VIP-LES/flight-computer-pcb/LEOS-flight-computer.csv

Reference | Qty | Value | Manufacturer | MPN | Digikey | LCSC | Description
BT1 | 1 | GPS Battery Backup | Memory Protection Devices | BU2032SM-JJ-GTR | BU2032SM-JJ-GCT-ND |  | CR2032 Backup Battery Holder
C1,C2 | 2 | 10p | Samsung Electro-Mechanics | CL10C100JB8NNNC | 1276-1027-1-ND | C1634 | 10P 50V C0G 0603
C3,C5,C7,C12 | 4 | 0.1u | Samsung Electro-Mechanics | CL10B104KB8NNNL | 1276-CL10B104KB8NNNLCT-ND | C913912 | 0.1U 50V X7R 0603
C4,C6 | 2 | 1u | Samsung Electro-Mechanics | CL10B105KA8NNNC | 1276-1184-1-ND | C29936 | 1U 25V X7R 0603
C8,C9 | 2 | 22u | Samsung Electro-Mechanics | CL21A226MAYNNNE | 1276-CL21A226MAYNNNECT-ND | C29936 | 22U 25V X5R 0805
D1 | 1 | Red LED | Lite-On Inc. | LTST-C150KRKT | 160-1405-1-ND |  | Red 631nm LED Indication - Discrete 2V 1206
D2 | 1 | Yellow LED | Lite-On Inc. | LTST-C150KSKT | 160-1406-1-ND |  | Yellow 591nm LED Indication - Discrete 2.1V 1206
D3 | 1 | Green LED | Lite-On Inc. | LTST-C230KGKT | 160-1456-1-ND |  | Green 571nm LED Indication - Discrete 2V 1206
J1,J2 | 2 | MicroFit_1x4 | Molex | 0436500409 | WM1882CT-ND | C563846 | Molex MicroFit3.0 1x4 Bus Connector
J4 | 1 | JST XH | JST | S4B-XH-A | 455-2243-ND |  | JST XH
J5 | 1 | JST XH | JST | S6B-XH-A | 455-S6B-XH-A-ND |  | JST XH
R1 | 1 | 120 | Stackpole Electronics Inc | CF14JT120R | CF14JT120RCT-ND |  | Resistor
R2,R3 | 2 | 4.7k | Vishay Dale | CRCW08054K70FKEA | 541-4.70KCCT-ND |  | 4.7 kOhms ±1% 0.25W, 1/4W Chip Resistor 0805
R4,R5,R6 | 3 | 130 | Vishay Dale | CRCW0805130RFKEA | 541-130CCT-ND |  | 130 Ohms ±1% 0.25W, 1/4W Chip Resistor 0805
SW1 | 1 | User Button | C&K | PTS645SK50-2 LFS | CKN9082-ND |  | Red Tactile Switch SPST-NO Top Actuated Through Hole
TP1 | 1 | CAN-H Test Point | Keystone Electronics | 5004 | 36-5004-ND |  | test point
TP2 | 1 | CAN-L Test Point | Keystone Electronics | 5116 | 36-5116-ND |  | test point
TP3 | 1 | 5V Test Point | Keystone Electronics | 5000 | 36-5000-ND |  | test point
TP4 | 1 | GND Test Point | Keystone Electronics | 5001 | 36-5001-ND |  | test point
U1 | 1 | MCP2562FD | Microchip Technology | MCP2562FDT-E/SN | MCP2562FDT-E/SNCT-ND | C511335 | High-Speed CAN Flexible Data Rate Transceiver
U2 | 1 | MCP2518FD | Microchip Technology | MCP2518FDT-E/SL | MCP2518FDT-E/SLCT-ND | C626758 | External CAN FD Controller with SPI Interface
U3 | 1 | SAM-M8Q | u-blox | SAM-M8Q-0 | 672-1054-1-ND |  | GPS ublox M8 variant
Y1 | 1 | 40 MHz | ECS Inc | ECS-400-10-37B2-CKY-TR | 50-ECS-400-10-37B2-CKY-TRCT-ND | C5357833 | 40 MHz ±10ppm Crystal 10pF 40 Ohms
