VIP-LES/flight-computer-pcb/LEOS-flight-computer.kicad_pcb

## KiCad design LEOS-flight-computer.kicad_pcb (2026-10-07)

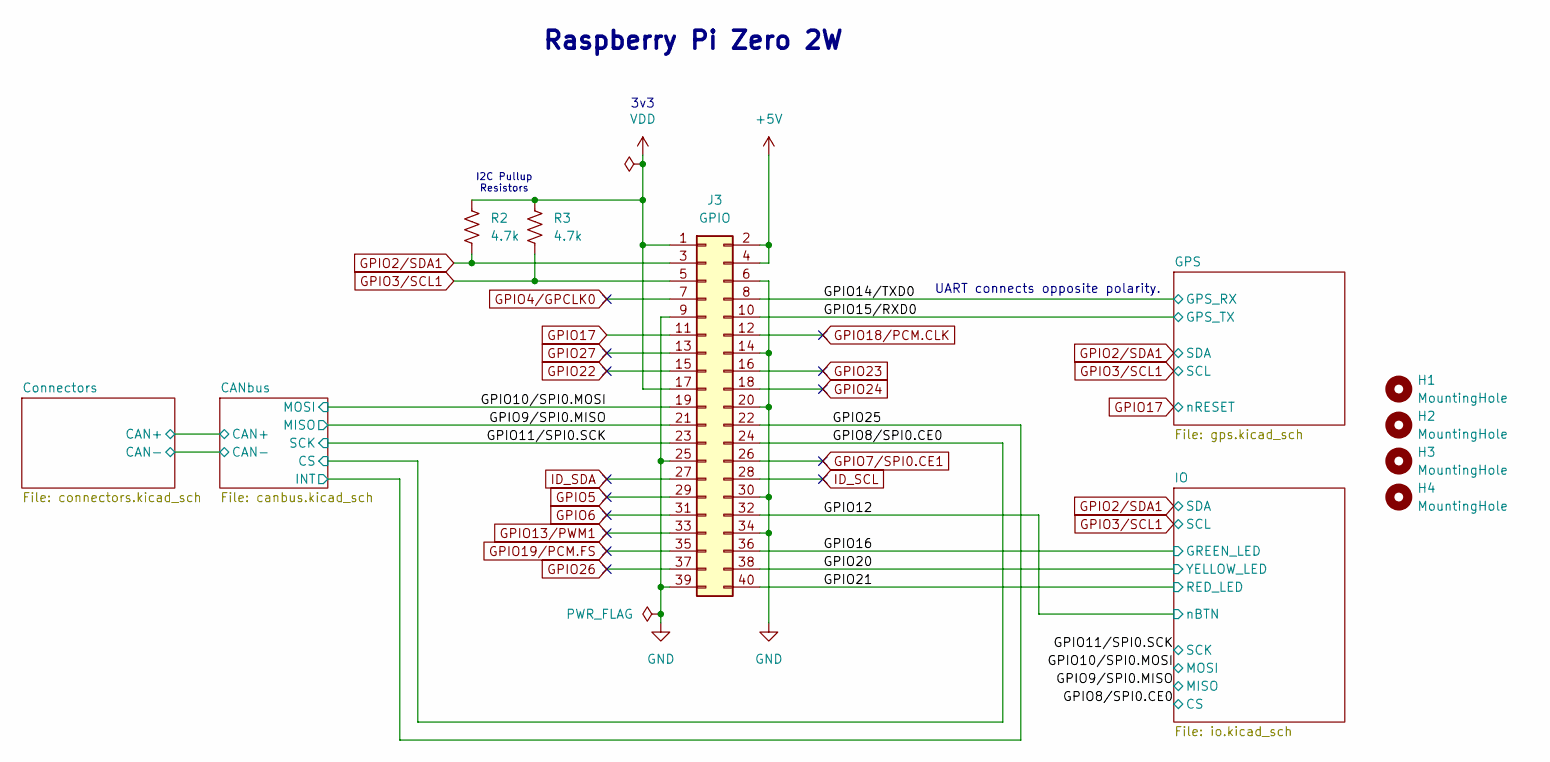
[picture p1: schematic LEOS-flight-computer.kicad_sch, LEOS Flight Computer]

Parts:
H1, H2, H3, H4: MountingHole; MountingHole_2.7mm_M2.5
J3: GPIO; PinSocket_2x20_P2.54mm_Vertical
R2, R3: 4.7k; R_0805_2012Metric; MPN CRCW08054K70FKEA; Digikey 541-4.70KCCT-ND

Connections:
+5V: J3.2, J3.4; also elsewhere on the board
/GPIO8/SPI0.CE0: J3.24; also elsewhere on the board
/GPIO9/SPI0.MISO: J3.21; also elsewhere on the board
/GPIO10/SPI0.MOSI: J3.19; also elsewhere on the board
/GPIO11/SPI0.SCK: J3.23; also elsewhere on the board
/GPIO12: J3.32; also elsewhere on the board
/GPIO14/TXD0: J3.8; also elsewhere on the board
/GPIO15/RXD0: J3.10; also elsewhere on the board
/GPIO16: J3.36; also elsewhere on the board
/GPIO20: J3.38; also elsewhere on the board
/GPIO21: J3.40; also elsewhere on the board
/GPIO25: J3.22; also elsewhere on the board
GND: J3.6, J3.9, J3.14, J3.20, J3.25, J3.30, J3.34, J3.39; also elsewhere on the board
GPIO2/SDA1: J3.3, R2.2; also elsewhere on the board
GPIO3/SCL1: J3.5, R3.2; also elsewhere on the board
GPIO4/GPCLK0: J3.7
GPIO5: J3.29
GPIO6: J3.31
GPIO7/SPI0.CE1: J3.26
GPIO13/PWM1: J3.33
GPIO17: J3.11; also elsewhere on the board
GPIO18/PCM.CLK: J3.12
GPIO19/PCM.FS: J3.35
GPIO22: J3.15
GPIO23: J3.16
GPIO24: J3.18
GPIO26: J3.37
GPIO27: J3.13
ID_SCL: J3.28
ID_SDA: J3.27
VDD: J3.1, J3.17, R2.1, R3.1; also elsewhere on the board

Notes on the sheet:
3v3
UART connects opposite polarity.
I2C Pullup Resistors
Raspberry Pi Zero 2W

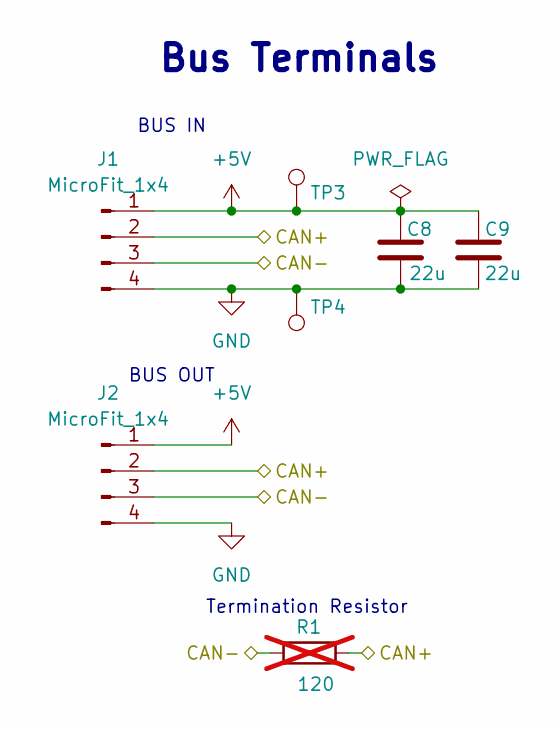
[picture p2: schematic connectors.kicad_sch, LEOS Connectors]

Parts:
C8, C9: 22u; C_0805_2012Metric; MPN CL21A226MAYNNNE; Digikey 1276-CL21A226MAYNNNECT-ND
J1, J2: MicroFit_1x4; Molex_MicroFit3.0_43650-0410_1x04_Horizontal; MPN 0436500409; Digikey WM1882CT-ND
R1: 120; R_Axial_DIN0207_L6.3mm_D2.5mm_P7.62mm_Horizontal; MPN CF14JT120R; Digikey CF14JT120RCT-ND; not fitted
TP3: 5V Test Point; TestPoint_Loop_D2.60mm_Drill0.9mm_Beaded; MPN 5000; Digikey 36-5000-ND
TP4: GND Test Point; TestPoint_Loop_D2.60mm_Drill0.9mm_Beaded; MPN 5001; Digikey 36-5001-ND

Connections:
+5V: C8.1, C9.1, J1.1, J2.1, TP3.1; also elsewhere on the board
/CANbus/CAN+: J1.2, J2.2, R1.2; also elsewhere on the board
/CANbus/CAN-: J1.3, J2.3, R1.1; also elsewhere on the board
GND: C8.2, C9.2, J1.4, J2.4, TP4.1; also elsewhere on the board

Notes on the sheet:
BUS OUT
Bus Terminals
BUS IN
Termination Resistor

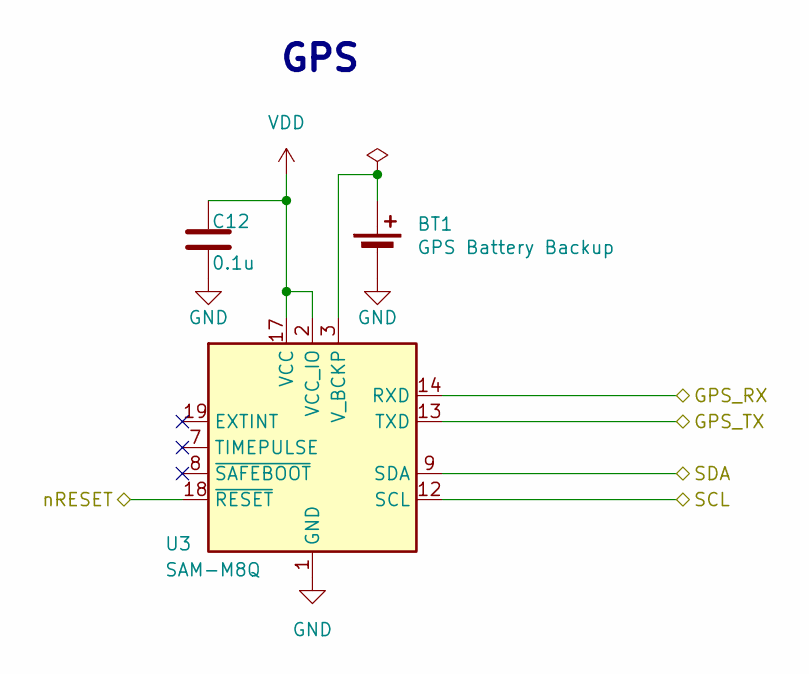
[picture p3: schematic gps.kicad_sch]

Parts:
BT1: GPS Battery Backup; BAT_BU2032SM-JJ-GTR; MPN BU2032SM-JJ-GTR; Digikey BU2032SM-JJ-GCT-ND
C12: 0.1u; C_0603_1608Metric; MPN CL10B104KB8NNNL; LCSC C913912
U3: SAM-M8Q; ublox_SAM-M8Q; MPN SAM-M8Q-0; Digikey 672-1054-1-ND

Connections:
/GPIO14/TXD0: U3.14 (RXD); also elsewhere on the board
/GPIO15/RXD0: U3.13 (TXD); also elsewhere on the board
GND: BT1.2 (-), C12.2, U3.1 (GND), U3.4 (GND), U3.5 (GND), U3.6 (GND), U3.10 (GND), U3.11 (GND), U3.15 (GND), U3.16 (GND), U3.20 (GND); also elsewhere on the board
GPIO2/SDA1: U3.9 (SDA); also elsewhere on the board
GPIO3/SCL1: U3.12 (SCL); also elsewhere on the board
GPIO17: U3.18 (~RESET); also elsewhere on the board
unnamed: BT1.1 (+), U3.3 (V_BCKP)
VDD: C12.1, U3.2 (VCC_IO), U3.17 (VCC); also elsewhere on the board

Notes on the sheet:
GPS

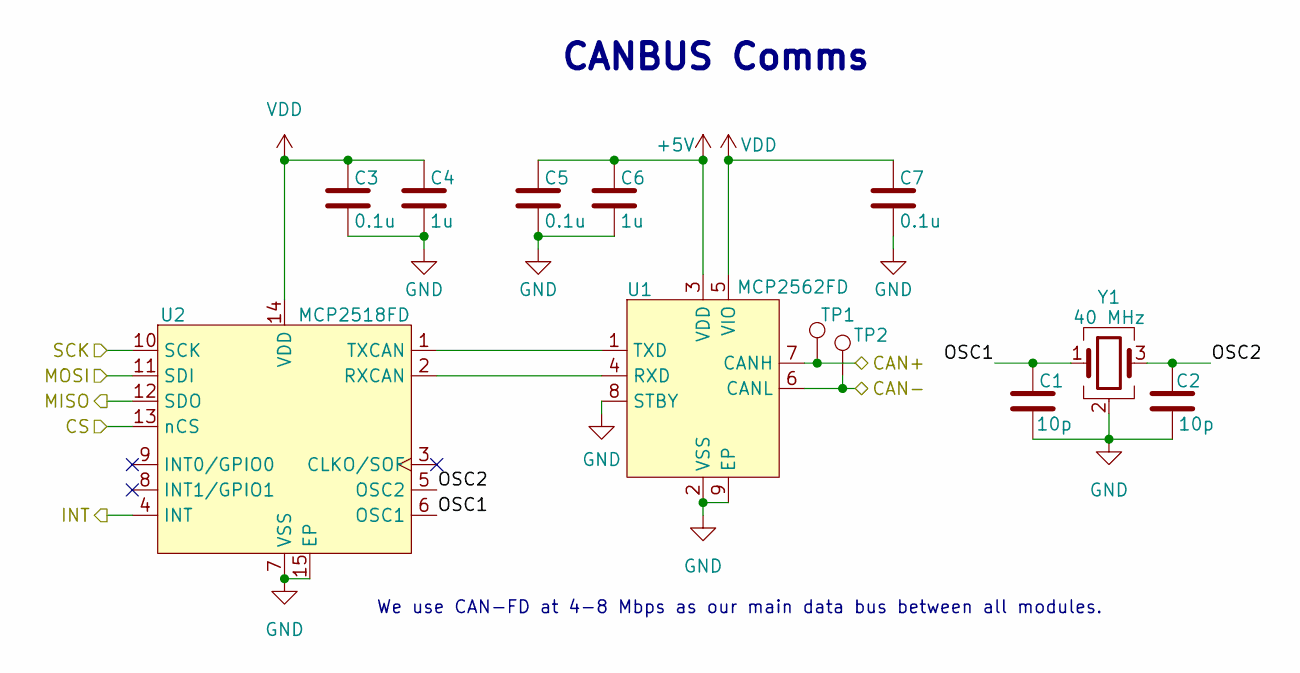
[picture p4: schematic canbus.kicad_sch, LEOS CANbus]

Parts:
C1, C2: 10p; C_0603_1608Metric; MPN CL10C100JB8NNNC; Digikey 1276-1027-1-ND
C3, C5, C7: 0.1u; C_0603_1608Metric; MPN CL10B104KB8NNNL; Digikey 1276-CL10B104KB8NNNLCT-ND
C4, C6: 1u; C_0603_1608Metric; MPN CL10B105KA8NNNC; Digikey 1276-1184-1-ND
TP1: CAN-H Test Point; TestPoint_Loop_D2.60mm_Drill0.9mm_Beaded; MPN 5004; Digikey 36-5004-ND
TP2: CAN-L Test Point; TestPoint_Loop_D2.60mm_Drill0.9mm_Beaded; MPN 5116; Digikey 36-5116-ND
U1: MCP2562FD; SOIC-8_3.9x4.9mm_P1.27mm; MPN MCP2562FDT-E/SN; LCSC C511335
U2: MCP2518FD; SOIC-14_3.9x8.7mm_P1.27mm; MPN MCP2518FDT-E/SL; LCSC C626758
Y1: 40 MHz; Crystal_SMD_2016-4Pin_2.0x1.6mm; MPN ECS-400-10-37B2-CKY-TR; Digikey 50-ECS-400-10-37B2-CKY-TRCT-ND

Connections:
+5V: C5.1, C6.1, U1.3 (VDD); also elsewhere on the board
/CANbus/CAN+: TP1.1, U1.7 (CANH); also elsewhere on the board
/CANbus/CAN-: TP2.1, U1.6 (CANL); also elsewhere on the board
/CANbus/OSC1: C1.2, U2.6 (OSC1), Y1.1
/CANbus/OSC2: C2.2, U2.5 (OSC2), Y1.3
/GPIO8/SPI0.CE0: U2.13 (nCS); also elsewhere on the board
/GPIO9/SPI0.MISO: U2.12 (SDO); also elsewhere on the board
/GPIO10/SPI0.MOSI: U2.11 (SDI); also elsewhere on the board
/GPIO11/SPI0.SCK: U2.10 (SCK); also elsewhere on the board
/GPIO25: U2.4 (INT); also elsewhere on the board
GND: C1.1, C2.1, C3.2, C4.2, C5.2, C6.2, C7.2, U1.2 (VSS), U1.8 (STBY), U1.9 (EP), U2.7 (VSS), U2.15 (EP), Y1.2 (G), Y1.4 (G); also elsewhere on the board
unnamed: U1.4 (RXD), U2.2 (RXCAN)
unnamed: U1.1 (TXD), U2.1 (TXCAN)
VDD: C3.1, C4.1, C7.1, U1.5 (VIO), U2.14 (VDD); also elsewhere on the board

Notes on the sheet:
CANBUS Comms
We use CAN-FD at 4-8 Mbps as our main data bus between all modules.

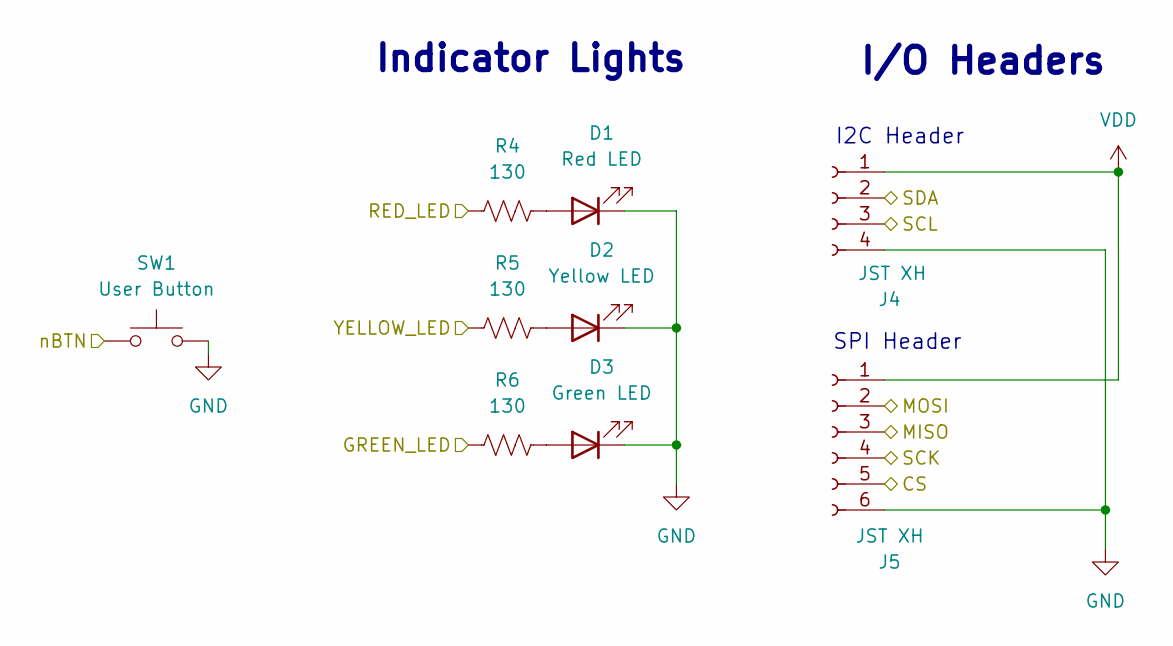
[picture p5: schematic io.kicad_sch, IO Headers]

Parts:
D1: Red LED; LED_1206_3216Metric; MPN LTST-C150KRKT; Digikey 160-1405-1-ND
D2: Yellow LED; LED_1206_3216Metric; MPN LTST-C150KSKT; Digikey 160-1406-1-ND
D3: Green LED; LED_1206_3216Metric; MPN LTST-C230KGKT; Digikey 160-1456-1-ND
J4: JST XH; JST_XH_S4B-XH-A_1x04_P2.50mm_Horizontal; MPN S4B-XH-A; Digikey 455-2243-ND
J5: JST XH; JST_XH_S6B-XH-A_1x06_P2.50mm_Horizontal; MPN S6B-XH-A; Digikey 455-S6B-XH-A-ND
R4, R5, R6: 130; R_0805_2012Metric; MPN CRCW0805130RFKEA; Digikey 541-130CCT-ND
SW1: User Button; SW_PUSH_6mm; MPN PTS645SK50-2 LFS; Digikey CKN9082-ND

Connections:
/GPIO8/SPI0.CE0: J5.5; also elsewhere on the board
/GPIO9/SPI0.MISO: J5.3; also elsewhere on the board
/GPIO10/SPI0.MOSI: J5.2; also elsewhere on the board
/GPIO11/SPI0.SCK: J5.4; also elsewhere on the board
/GPIO12: SW1.1; also elsewhere on the board
/GPIO16: R6.1; also elsewhere on the board
/GPIO20: R5.1; also elsewhere on the board
/GPIO21: R4.1; also elsewhere on the board
GND: D1.1 (K), D2.1 (K), D3.1 (K), J4.4, J5.6, SW1.2; also elsewhere on the board
GPIO2/SDA1: J4.2; also elsewhere on the board
GPIO3/SCL1: J4.3; also elsewhere on the board
unnamed: D1.2 (A), R4.2
unnamed: D2.2 (A), R5.2
unnamed: D3.2 (A), R6.2
VDD: J4.1, J5.1; also elsewhere on the board

Notes on the sheet:
SPI Header
I2C Header
Indicator Lights
I/O Headers

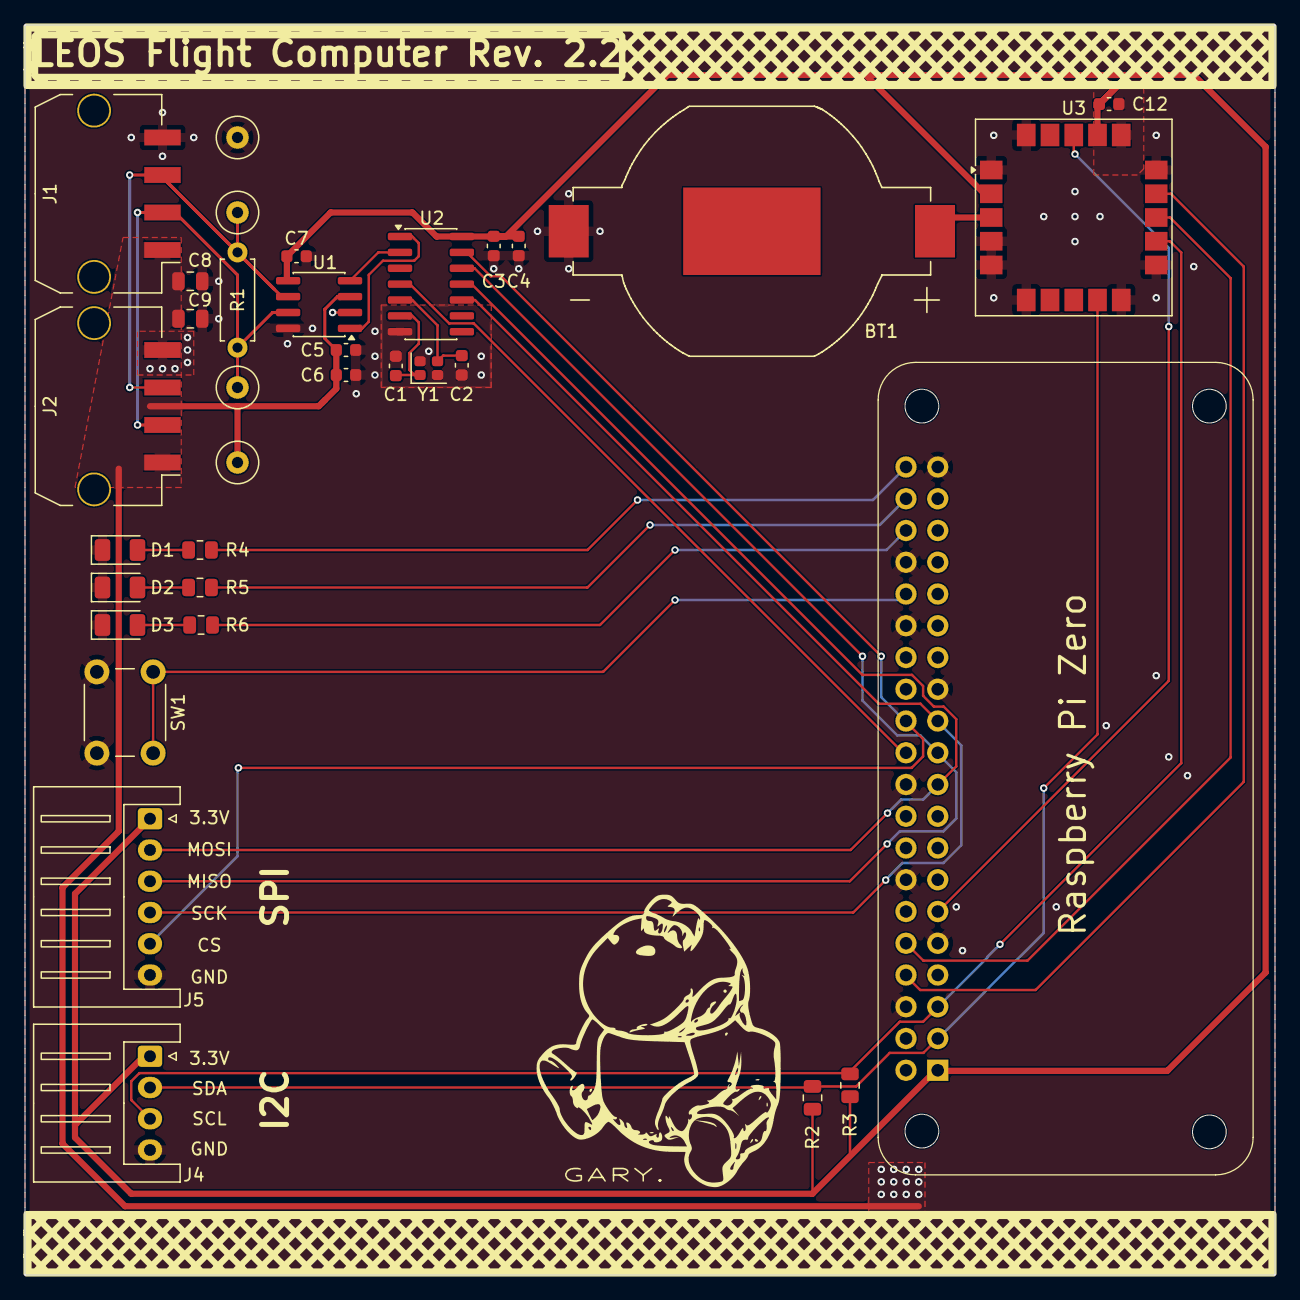
[picture p6: board LEOS-flight-computer.kicad_pcb from above]

Board: 2 copper layers, 100.0 x 100.0 mm, 38 parts (1 on the bottom side), 27 nets.
