VIP-LES/flight-computer-pcb/(commit log)

2025-09-15 Updated Initial Layout
    [LEOS-flight-computer.kicad_pcb, LEOS-flight-computer.kicad_sch]
2025-09-15 Change Silkscreen name to flight computer
    [LEOS-flight-computer.kicad_pcb]
2025-09-15 Corrected layout for flight computer with breakout headers routed
    [LEOS-flight-computer.kicad_pcb, LEOS-flight-computer.kicad_sch]
2025-09-17 I routed and schematiced the gps model (SAM-M8Q).
    [LEOS-flight-computer.kicad_pcb, LEOS-flight-computer.kicad_sch]
2025-09-17 Added no connects to the pins on the gps module that we aren't using.
    [LEOS-flight-computer.kicad_sch]
2025-09-22 Routed and schematiced a coin cell bettery that is connected to V backup on the gps module
    [LEOS-flight-computer.kicad_pcb, LEOS-flight-computer.kicad_sch]
2025-09-27 added footprint for better battery holder
2025-09-27 changed the battery holder to a better one
    [LEOS-flight-computer.kicad_pcb, LEOS-flight-computer.kicad_sch]
2025-09-30 Added labels and CANBus SPI connections
    [LEOS-flight-computer.kicad_pcb, LEOS-flight-computer.kicad_sch]
2025-09-30 Added part numbers
    [LEOS-flight-computer.kicad_sch]
2025-09-30 Added manufacturers and MPNs for the parts
    [LEOS-flight-computer.kicad_sch]
2025-10-01 Final updates before production - Includes GARY.
    [LEOS-flight-computer.kicad_pcb, LEOS-flight-computer.kicad_sch]
2026-02-17 v2.1 with redesigned board, connectors, and improved access to RPi
    [LEOS-flight-computer.kicad_pcb, LEOS-flight-computer.kicad_sch, canbus.kicad_sch, connectors.kicad_sch, gps.kicad_sch, io.kicad_sch]
2026-02-17 Change output dirs for fabrication
    [LEOS-flight-computer.kicad_pcb]
2026-02-17 Add .gitignore for KiCad and backup files
2026-02-18 v2.2 with added indicator LEDs and a user button
    [LEOS-flight-computer.kicad_pcb, LEOS-flight-computer.kicad_sch, io.kicad_sch]
2026-10-07 update to kicad 10
